RASAC-Dev/RASAC_board/KiCad_files/RASAC.kicad_pcb

## KiCad design KiCad_files/RASAC.kicad_pcb (2019-04-03)

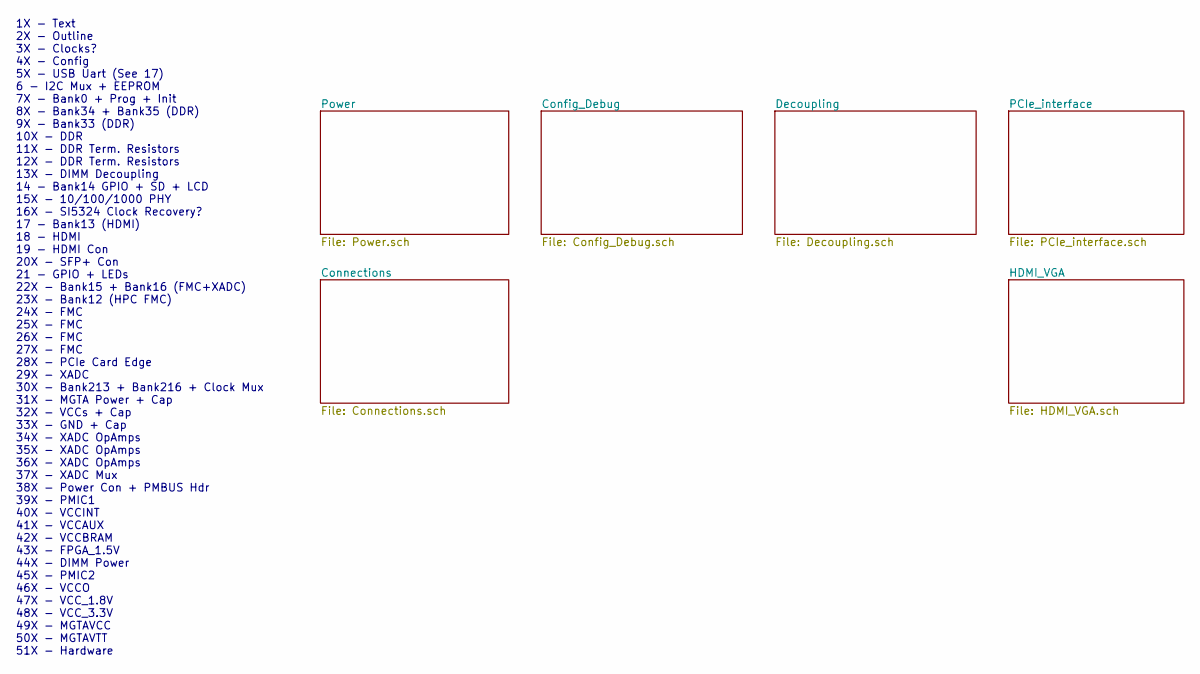
[picture p10: schematic RASAC.sch, Reconfigurable Application-Specific Accelerator Card]

Notes on the sheet:
1X - Text 2X - Outline 3X - Clocks? 4X - Config 5X - USB Uart (See 17) 6 - I2C Mux + EEPROM 7X - Bank0 + Prog + Init 8X - Bank34 + Bank35 (DDR) 9X - Bank33 (DDR) 10X - DDR 11X - DDR Term. Resistors 12X - DDR Term. Resistors 13X - DIMM Decoupling 14 - Bank14 GPIO + SD + LCD 15X - 10/100/1000 PHY 16X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

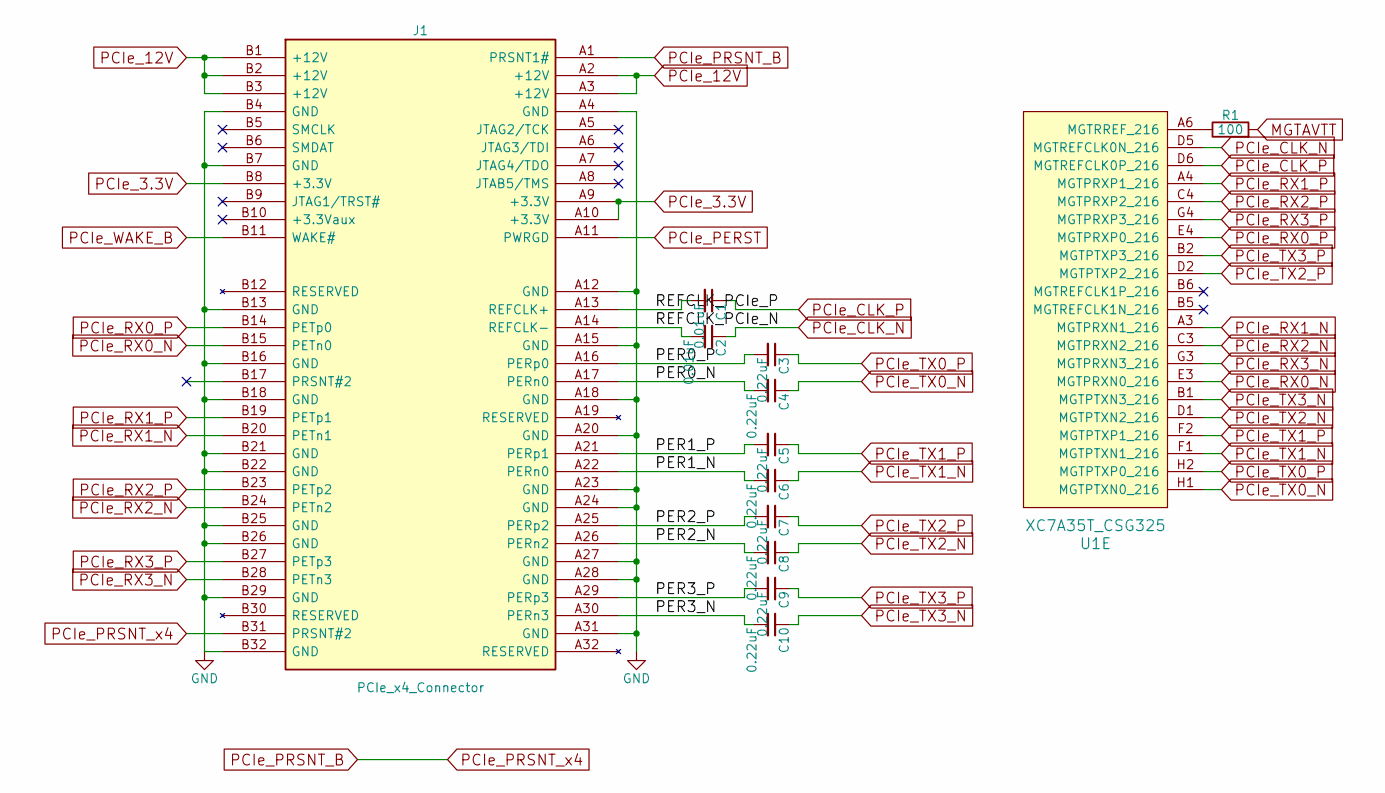
[picture p11: schematic PCIe_interface.sch, Reconfigurable Application-Specific Accelerator Card]

Parts:
C1, C2: 0.01uF; C_1206
C3, C4, C5, C6, C7, C8, C9, C10: 0.22uF; C_0805
J1: PCIe_x4_Connector; pciex4fingers
R1: 100; R_0603
U1: XC7A35T_CSG325; BGA-324_15.0x15.0mm_Layout18x18_P0.8mm_Ball0.5mm_Pad0.4mm_N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

Connections:
/PCIe_interface/PER0_N: C4.2, J1.A17 (PERn0)
/PCIe_interface/PER0_P: C3.2, J1.A16 (PERp0)
/PCIe_interface/PER1_N: C6.2, J1.A22 (PERn0)
/PCIe_interface/PER1_P: C5.2, J1.A21 (PERp1)
/PCIe_interface/PER2_N: C8.2, J1.A26 (PERn2)
/PCIe_interface/PER2_P: C7.2, J1.A25 (PERp2)
/PCIe_interface/PER3_N: C10.2, J1.A30 (PERn3)
/PCIe_interface/PER3_P: C9.2, J1.A29 (PERp3)
/PCIe_interface/REFCLK_PCIe_N: C2.2, J1.A14 (REFCLK-)
/PCIe_interface/REFCLK_PCIe_P: C1.2, J1.A13 (REFCLK+)
GND: J1.A4 (GND), J1.A12 (GND), J1.A15 (GND), J1.A18 (GND), J1.A20 (GND), J1.A23 (GND), J1.A24 (GND), J1.A27 (GND), J1.A28 (GND), J1.A31 (GND), J1.B4 (GND), J1.B7 (GND), J1.B13 (GND), J1.B16 (GND), J1.B18 (GND), J1.B21 (GND), J1.B22 (GND), J1.B25 (GND), J1.B26 (GND), J1.B29 (GND), J1.B32 (GND); also elsewhere on the board
MGTAVTT: R1.2; also elsewhere on the board
unnamed: R1.1, U1.A6 (MGTRREF_216)
PCIe_3.3V: J1.A9 (+3.3V), J1.A10 (+3.3V), J1.B8 (+3.3V); also elsewhere on the board
PCIe_12V: J1.A2 (+12V), J1.A3 (+12V), J1.B1 (+12V), J1.B2 (+12V), J1.B3 (+12V); also elsewhere on the board
PCIe_CLK_N: C2.1, U1.D5 (MGTREFCLK0N_216)
PCIe_CLK_P: C1.1, U1.D6 (MGTREFCLK0P_216)
PCIe_PERST: J1.A11 (PWRGD); also elsewhere on the board
PCIe_PRSNT_B: J1.A1 (PRSNT1#), J1.B31 (PRSNT#2)
PCIe_RX0_N: J1.B15 (PETn0), U1.E3 (MGTPRXN0_216)
PCIe_RX0_P: J1.B14 (PETp0), U1.E4 (MGTPRXP0_216)
PCIe_RX1_N: J1.B20 (PETn1), U1.A3 (MGTPRXN1_216)
PCIe_RX1_P: J1.B19 (PETp1), U1.A4 (MGTPRXP1_216)
PCIe_RX2_N: J1.B24 (PETn2), U1.C3 (MGTPRXN2_216)
PCIe_RX2_P: J1.B23 (PETp2), U1.C4 (MGTPRXP2_216)
PCIe_RX3_N: J1.B28 (PETn3), U1.G3 (MGTPRXN3_216)
PCIe_RX3_P: J1.B27 (PETp3), U1.G4 (MGTPRXP3_216)
PCIe_TX0_N: C4.1, U1.H1 (MGTPTXN0_216)
PCIe_TX0_P: C3.1, U1.H2 (MGTPTXP0_216)
PCIe_TX1_N: C6.1, U1.F1 (MGTPTXN1_216)
PCIe_TX1_P: C5.1, U1.F2 (MGTPTXP1_216)
PCIe_TX2_N: C8.1, U1.D1 (MGTPTXN2_216)
PCIe_TX2_P: C7.1, U1.D2 (MGTPTXP2_216)
PCIe_TX3_N: C10.1, U1.B1 (MGTPTXN3_216)
PCIe_TX3_P: C9.1, U1.B2 (MGTPTXP3_216)
PCIe_WAKE_B: J1.B11 (WAKE#); also elsewhere on the board

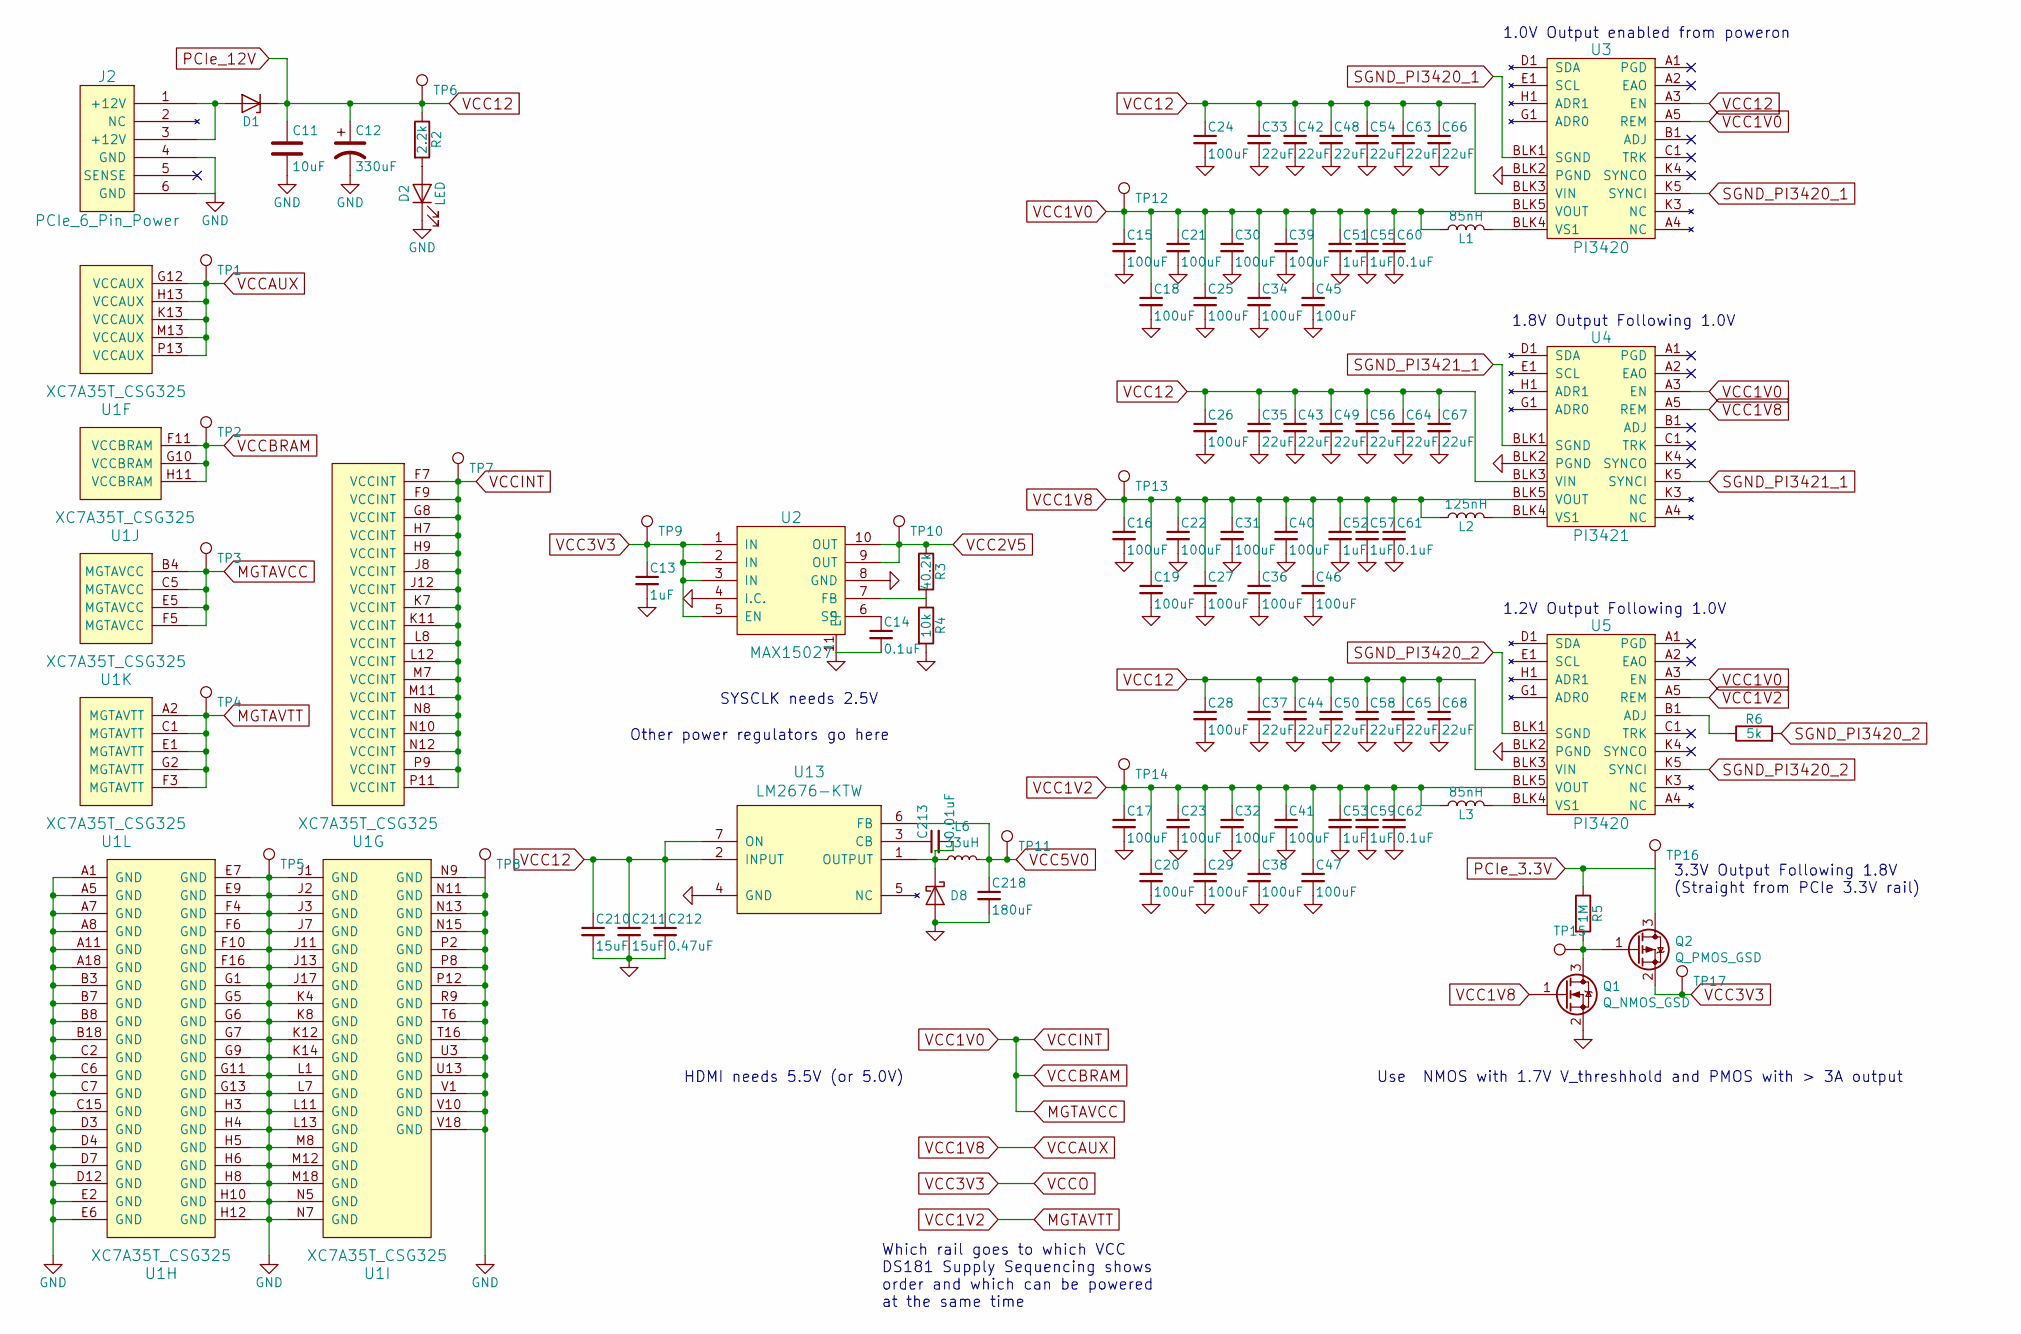
[picture p12: schematic Power.sch, Reconfigurable Application-Specific Accelerator Card]

Parts:
C11: 10uF; C_0805
C12: 330uF; C_1210
C13, C51, C52, C53, C55, C57, C59: 1uF; C_0805
C14: 0.1uF; C_0402
C15, C16, C17, C18, C19, C20, C21, C22, C23, C24, C25, C26, C27, C28, C29, C30, C31, C32, C34, C36, C38, C39, C40, C41, C45, C46, C47: 100uF; C_1210
C33, C35, C37, C42, C43, C44, C48, C49, C50, C54, C56, C58, C63, C64, C65, C66, C67, C68: 22uF; C_0805
C60, C61, C62: 0.1uF; C_0805
C210, C211: 15uF; C_1210
C212: 0.47uF; C_0805
C213: 0.01uF; C_1206
C218: 180uF; C_1206
D1: D_Zener; D_SOD-123
D2: LED; LED_0603
D8: D_Schottky; D_SOD-123
J2: PCIe_6_Pin_Power; Molex_MiniFit-JR-5569-06A2_2x03x4.20mm_Angled
L1, L3: 85nH; L_1210
L2: 125nH; L_1210
L6: 33uH; L_0805
Q1: Q_NMOS_GSD; SOT-23
Q2: Q_PMOS_GSD; SOT-23
R2: 2.2k; R_0805
R3: 40.2k; R_0402
R4: 10k; R_0805
R5: 1M; R_0603
R6: 5k; R_0805
TP1, TP2, TP3, TP4, TP5, TP6, TP7, TP8, TP9, TP10, TP11, TP12, TP13, TP14, TP15, TP16, TP17: TestPoint; Measurement_Point_Round-SMD-Pad_Small
U1: XC7A35T_CSG325; BGA-324_15.0x15.0mm_Layout18x18_P0.8mm_Ball0.5mm_Pad0.4mm_N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
U2: MAX15027; TDFN-10_3x3mm_Pitch0.5mm
U3, U5: PI3420; LGA-123_10x14mm_Pitch1.0mm
U4: PI3421; LGA-123_10x14mm_Pitch1.0mm
U13: LM2676-KTW; TO-263-7_TabPin4

Connections:
GND: C11.2, C12.2, C13.2, C14.2, C15.2, C16.2, C17.2, C18.2, C19.2, C20.2, C21.2, C22.2, C23.2, C24.2, C25.2, C26.2, C27.2, C28.2, C29.2, C30.2, C31.2, C32.2, C33.2, C34.2, C35.2, C36.2, C37.2, C38.2, C39.2, C40.2, C41.2, C42.2, C43.2, C44.2, C45.2, C46.2, C47.2, C48.2, C49.2, C50.2, C51.2, C52.2, C53.2, C54.2, C55.2, C56.2, C57.2, C58.2, C59.2, C60.2, C61.2, C62.2, C63.2, C64.2, C65.2, C66.2, C67.2, C68.2, C210.2, C211.2, C212.2, C218.2, D2.1 (K), D8.2 (A), J2.4 (GND), J2.6 (GND), Q1.2 (S), R4.2, TP5.1, TP8.1, U1.A1 (GND), U1.A5 (GND), U1.A7 (GND), U1.A8 (GND), U1.A11 (GND), U1.A18 (GND), U1.B3 (GND), U1.B7 (GND), U1.B8 (GND), U1.B18 (GND), U1.C2 (GND), U1.C6 (GND), U1.C7 (GND), U1.C15 (GND), U1.D3 (GND), U1.D4 (GND), U1.D7 (GND), U1.D12 (GND), U1.E2 (GND), U1.E6 (GND), U1.E7 (GND), U1.E9 (GND), U1.F4 (GND), U1.F6 (GND), U1.F10 (GND), U1.F16 (GND), U1.G1 (GND), U1.G5 (GND), U1.G6 (GND), U1.G7 (GND), U1.G9 (GND), U1.G11 (GND), U1.G13 (GND), U1.H3 (GND), U1.H4 (GND), U1.H5 (GND), U1.H6 (GND), U1.H8 (GND), U1.H10 (GND), U1.H12 (GND), U1.J1 (GND), U1.J2 (GND), U1.J3 (GND), U1.J7 (GND), U1.J11 (GND), U1.J13 (GND), U1.J17 (GND), U1.K4 (GND), U1.K8 (GND), U1.K12 (GND), U1.K14 (GND), U1.L1 (GND), U1.L7 (GND), U1.L11 (GND), U1.L13 (GND), U1.M8 (GND), U1.M12 (GND), U1.M18 (GND), U1.N5 (GND), U1.N7 (GND), U1.N9 (GND), U1.N11 (GND), U1.N13 (GND), U1.N15 (GND), U1.P2 (GND), U1.P8 (GND), U1.P12 (GND), U1.R9 (GND), U1.T6 (GND), U1.T16 (GND), U1.U3 (GND), U1.U13 (GND), U1.V1 (GND), U1.V10 (GND), U1.V18 (GND), U2.4 (I.C.), U2.8 (GND), U2.11 (EP), U3.BLK2 (PGND), U4.BLK2 (PGND), U5.BLK2 (PGND), U13.4 (GND); also elsewhere on the board
MGTAVCC: C15.1, C18.1, C21.1, C25.1, C30.1, C34.1, C39.1, C45.1, C51.1, C55.1, C60.1, L1.1, TP2.1, TP3.1, TP7.1, TP12.1, U1.B4 (MGTAVCC), U1.C5 (MGTAVCC), U1.E5 (MGTAVCC), U1.F5 (MGTAVCC), U1.F7 (VCCINT), U1.F9 (VCCINT), U1.F11 (VCCBRAM), U1.G8 (VCCINT), U1.G10 (VCCBRAM), U1.H7 (VCCINT), U1.H9 (VCCINT), U1.H11 (VCCBRAM), U1.J8 (VCCINT), U1.J12 (VCCINT), U1.K7 (VCCINT), U1.K11 (VCCINT), U1.L8 (VCCINT), U1.L12 (VCCINT), U1.M7 (VCCINT), U1.M11 (VCCINT), U1.N8 (VCCINT), U1.N10 (VCCINT), U1.N12 (VCCINT), U1.P9 (VCCINT), U1.P11 (VCCINT), U3.A5 (REM), U3.BLK5 (VOUT), U4.A3 (EN), U5.A3 (EN); also elsewhere on the board
MGTAVTT: C17.1, C20.1, C23.1, C29.1, C32.1, C38.1, C41.1, C47.1, C53.1, C59.1, C62.1, L3.1, TP4.1, TP14.1, U1.A2 (MGTAVTT), U1.C1 (MGTAVTT), U1.E1 (MGTAVTT), U1.F3 (MGTAVTT), U1.G2 (MGTAVTT), U5.A5 (REM), U5.BLK5 (VOUT); also elsewhere on the board
unnamed: C14.1, U2.6 (SS)
unnamed: C213.1, U13.3 (CB)
unnamed: C213.2, D8.1 (K), L6.1, U13.1 (OUTPUT)
unnamed: D1.2 (A), J2.1 (+12V), J2.3 (+12V)
unnamed: D2.2 (A), R2.2
unnamed: L1.2, U3.BLK4 (VS1)
unnamed: L2.2, U4.BLK4 (VS1)
unnamed: L3.2, U5.BLK4 (VS1)
unnamed: Q1.3 (D), Q2.1 (G), R5.2, TP15.1
unnamed: R3.2, R4.1, U2.7 (FB)
unnamed: R6.1, U5.B1 (ADJ)
PCIe_3.3V: Q2.3 (D), R5.1, TP16.1; also elsewhere on the board
PCIe_12V: C11.1, C12.1, C24.1, C26.1, C28.1, C33.1, C35.1, C37.1, C42.1, C43.1, C44.1, C48.1, C49.1, C50.1, C54.1, C56.1, C58.1, C63.1, C64.1, C65.1, C66.1, C67.1, C68.1, C210.1, C211.1, C212.1, D1.1 (K), R2.1, TP6.1, U3.A3 (EN), U3.BLK3 (VIN), U4.BLK3 (VIN), U5.BLK3 (VIN), U13.2 (INPUT), U13.7 (ON); also elsewhere on the board
SGND_PI3420_1: U3.BLK1 (SGND), U3.K5 (SYNCI)
SGND_PI3420_2: R6.2, U5.BLK1 (SGND), U5.K5 (SYNCI)
SGND_PI3421_1: U4.BLK1 (SGND), U4.K5 (SYNCI)
VCC1V8: C16.1, C19.1, C22.1, C27.1, C31.1, C36.1, C40.1, C46.1, C52.1, C57.1, C61.1, L2.1, Q1.1 (G), TP1.1, TP13.1, U1.G12 (VCCAUX), U1.H13 (VCCAUX), U1.K13 (VCCAUX), U1.M13 (VCCAUX), U1.P13 (VCCAUX), U4.A5 (REM), U4.BLK5 (VOUT); also elsewhere on the board
VCC2V5: R3.1, TP10.1, U2.9 (OUT), U2.10 (OUT); also elsewhere on the board
VCC3V3: C13.1, Q2.2 (S), TP9.1, TP17.1, U2.1 (IN), U2.2 (IN), U2.3 (IN), U2.5 (EN); also elsewhere on the board
VCC5V0: C218.1, L6.2, TP11.1, U13.6 (FB); also elsewhere on the board

Notes on the sheet:
Use NMOS with 1.7V V_threshhold and PMOS with > 3A output
Other power regulators go here
1.2V Output Following 1.0V
1.8V Output Following 1.0V
1.0V Output enabled from poweron
3.3V Output Following 1.8V (Straight from PCIe 3.3V rail)
Which rail goes to which VCC DS181 Supply Sequencing shows order and which can be powered at the same time
SYSCLK needs 2.5V
HDMI needs 5.5V (or 5.0V)

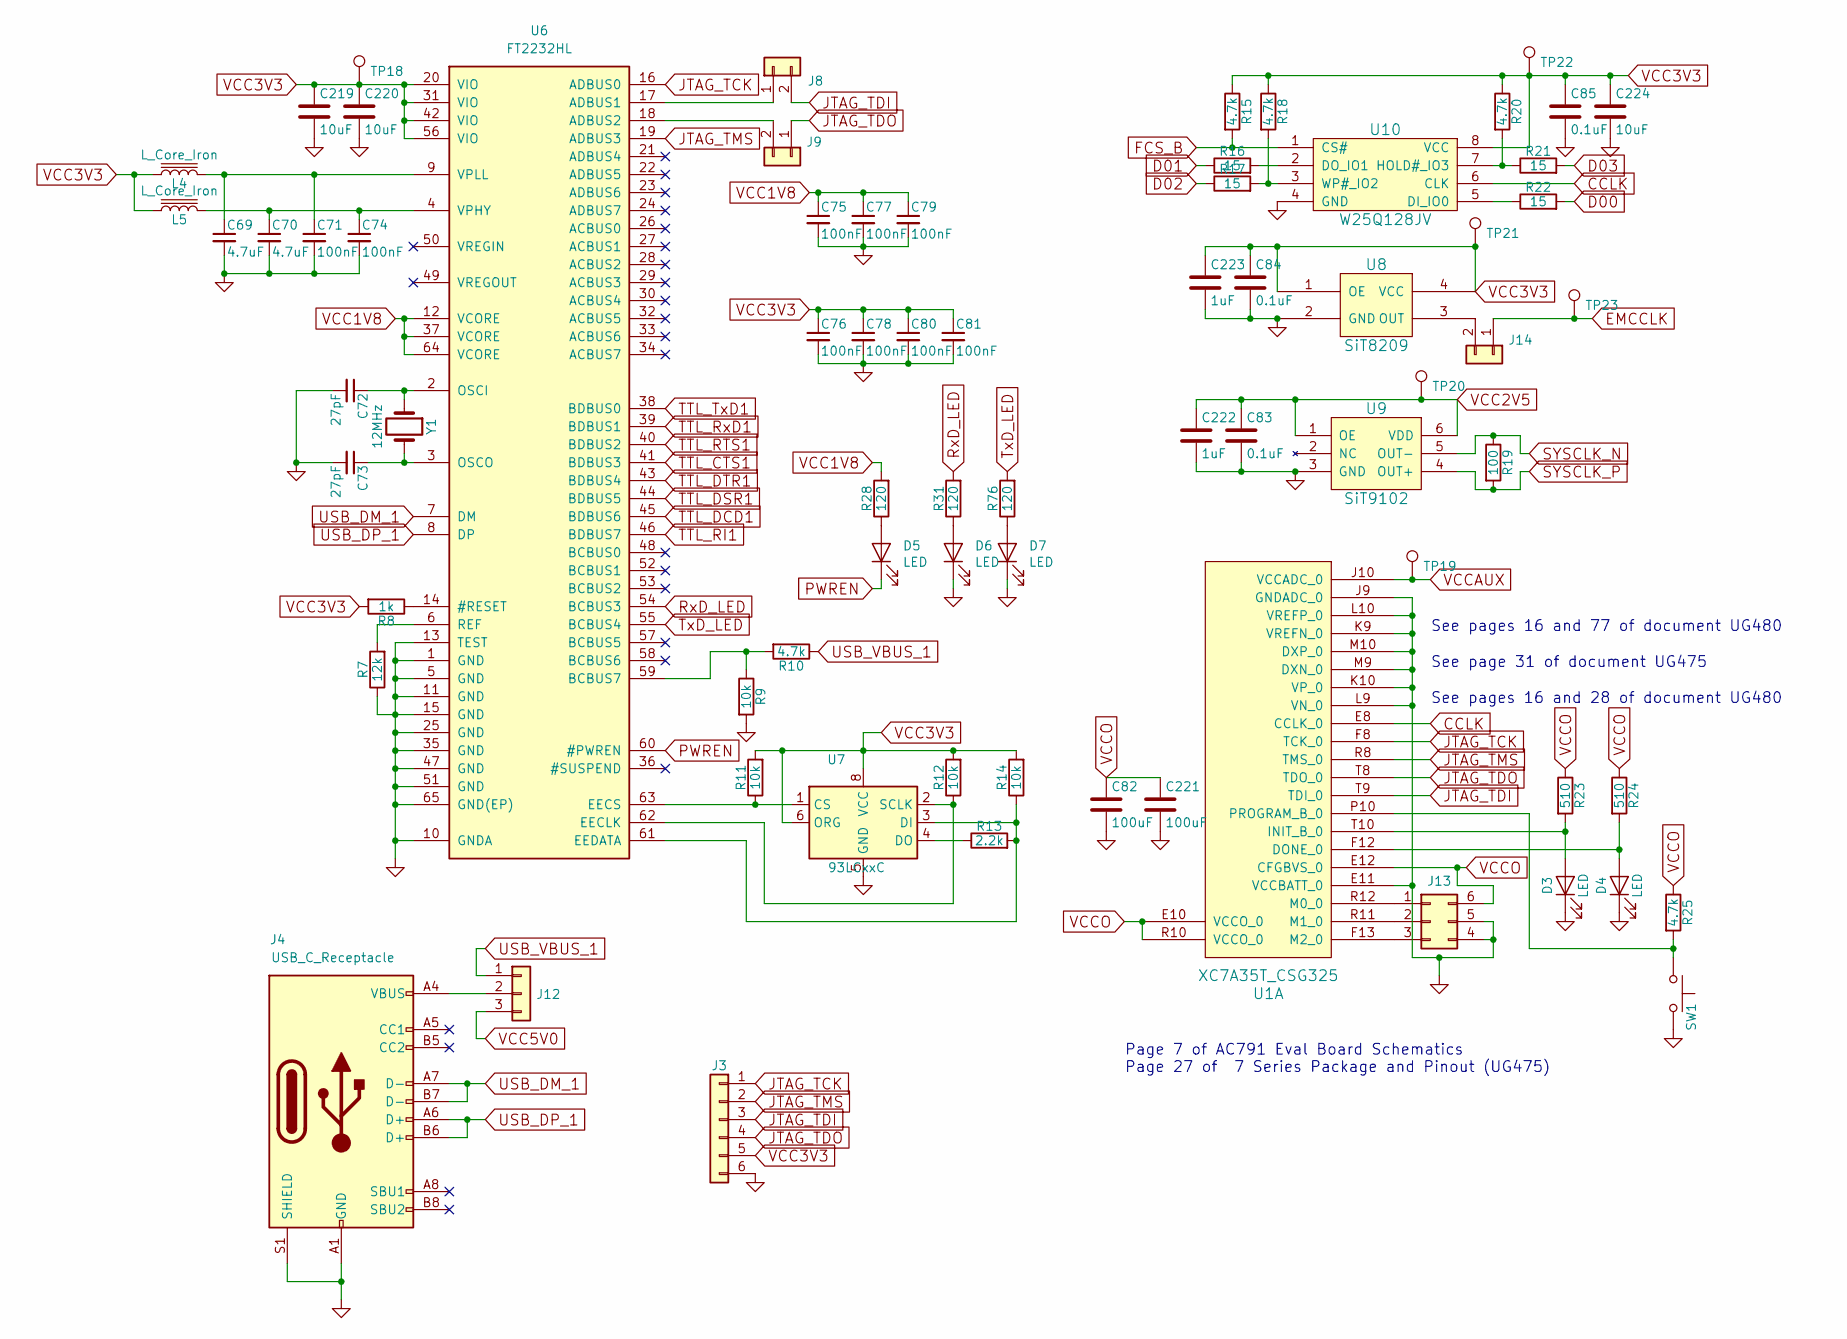
[picture p13: schematic Config_Debug.sch, Reconfigurable Application-Specific Accelerator Card]

Parts:
C69, C70: 4.7uF; C_0603
C71, C74, C75, C76, C77, C78, C79, C80, C81: 100nF; C_0805
C72, C73: 27pF; C_0805
C82: 100uF; C_0805
C83, C84, C85: 0.1uF; C_0805
C219, C220, C224: 10uF; C_0805
C221: 100uF; C_1210
C222, C223: 1uF; C_0805
D3, D4, D5, D6, D7: LED; LED_0603
J3: Conn_01x06; Pin_Header_Straight_2x03_Pitch2.54mm
J4: USB_C_Receptacle; USB_C_Receptacle_Amphenol_12401610E4-2A
J8, J9, J14: Conn_01x02; Pin_Header_Straight_1x02_Pitch2.54mm
J12: Conn_01x03; Pin_Header_Straight_1x03_Pitch2.54mm
J13: Conn_02x03_Counter_Clockwise; Pin_Header_Straight_2x03_Pitch2.54mm_SMD
L4, L5: L_Core_Iron; L_0805
R7: 12k; R_0402
R8: 1k; R_0805
R9, R11, R12, R14: 10k; R_0805
R10, R15, R18, R20, R25: 4.7k; R_0805
R13: 2.2k; R_0805
R16, R17, R21, R22: 15; R_0805
R19: 100; R_0603
R23, R24: 510; R_0805
R28, R31, R76: 120; R_0805
SW1: SW_Push; SW_SPST_PTS645
TP18, TP19, TP20, TP21, TP22, TP23: TestPoint; Measurement_Point_Round-SMD-Pad_Small
U1: XC7A35T_CSG325; BGA-324_15.0x15.0mm_Layout18x18_P0.8mm_Ball0.5mm_Pad0.4mm_N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
U6: FT2232HL; LQFP-64-1EP_10x10mm_Pitch0.5mm; MPN FT2232HL
U7: 93LCxxC; SOIC-8-N
U8: SiT8209; 4-SMD
U9: SiT9102; 6-SMD
U10: W25Q128JV; SOIC-8-N
Y1: 12MHz; Crystal_SMD_HC49-SD

Connections:
CCLK: U1.E8 (CCLK_0), U10.6 (CLK)
D00: R22.2; also elsewhere on the board
D01: R16.1; also elsewhere on the board
D02: R17.1; also elsewhere on the board
D03: R21.2; also elsewhere on the board
EMCCLK: J14.1, TP23.1; also elsewhere on the board
FCS_B: R15.2, U10.1 (CS#); also elsewhere on the board
GND: C69.2, C70.2, C71.2, C72.2, C73.2, C74.2, C75.2, C76.2, C77.2, C78.2, C79.2, C80.2, C81.2, C82.2, C83.2, C84.2, C85.2, C219.2, C220.2, C221.2, C222.2, C223.2, C224.2, D3.1 (K), D4.1 (K), D6.1 (K), D7.1 (K), J3.6, J4.A1 (GND), J4.A12 (GND), J4.B1 (GND), J4.B12 (GND), J4.S1 (SHIELD), J13.4, J13.5, R7.1, R9.2, SW1.2, U1.E11 (VCCBATT_0), U1.J9 (GNDADC_0), U1.K9 (VREFN_0), U1.K10 (VP_0), U1.L9 (VN_0), U1.L10 (VREFP_0), U1.M9 (DXN_0), U1.M10 (DXP_0), U6.1 (GND), U6.5 (GND), U6.10 (GNDA), U6.11 (GND), U6.13 (TEST), U6.15 (GND), U6.25 (GND), U6.35 (GND), U6.47 (GND), U6.51 (GND), U6.65 (GND(EP)), U7.5 (GND), U8.2 (GND), U9.3 (GND), U10.4 (GND); also elsewhere on the board
JTAG_TCK: J3.1, U1.F8 (TCK_0), U6.16 (ADBUS0)
JTAG_TDI: J3.3, J8.2, U1.T9 (TDI_0)
JTAG_TDO: J3.4, J9.1, U1.T8 (TDO_0)
JTAG_TMS: J3.2, U1.R8 (TMS_0), U6.19 (ADBUS3)
unnamed: C69.1, C71.1, L4.2, U6.9 (VPLL)
unnamed: C70.1, C74.1, L5.2, U6.4 (VPHY)
unnamed: C72.1, U6.2 (OSCI), Y1.1
unnamed: C73.1, U6.3 (OSCO), Y1.2
unnamed: D3.2 (A), R23.2, U1.T10 (INIT_B_0)
unnamed: D4.2 (A), R24.2, U1.F12 (DONE_0)
unnamed: D5.2 (A), R28.1
unnamed: D6.2 (A), R31.1
unnamed: D7.2 (A), R76.1
unnamed: J8.1, U6.17 (ADBUS1)
unnamed: J9.2, U6.18 (ADBUS2)
unnamed: J4.A4 (VBUS), J4.A9 (VBUS), J4.B4 (VBUS), J4.B9 (VBUS), J12.2
unnamed: J13.1, U1.R12 (M0_0)
unnamed: J13.2, U1.R11 (M1_0)
unnamed: J13.3, U1.F13 (M2_0)
unnamed: J14.2, U8.3 (OUT)
unnamed: R7.2, U6.6 (REF)
unnamed: R8.1, U6.14 (#RESET)
unnamed: R9.1, R10.2, U6.59 (BCBUS7)
unnamed: R11.1, U6.63 (EECS), U7.1 (CS)
unnamed: R12.1, U6.62 (EECLK), U7.2 (SCLK)
unnamed: R13.1, U7.4 (DO)
unnamed: R13.2, R14.1, U6.61 (EEDATA), U7.3 (DI)
unnamed: R16.2, U10.2 (DO_IO1)
unnamed: R17.2, R18.2, U10.3 (WP#_IO2)
unnamed: R20.2, R21.1, U10.7 (HOLD#_IO3)
unnamed: R22.1, U10.5 (DI_IO0)
unnamed: R25.2, SW1.1, U1.P10 (PROGRAM_B_0)
PWREN: D5.1 (K), U6.60 (#PWREN)
RxD_LED: R31.2, U6.54 (BCBUS3)
SYSCLK_N: R19.1, U9.5 (OUT-); also elsewhere on the board
SYSCLK_P: R19.2, U9.4 (OUT+); also elsewhere on the board
TTL_CTS1: U6.41 (BDBUS3); also elsewhere on the board
TTL_DCD1: U6.45 (BDBUS6); also elsewhere on the board
TTL_DSR1: U6.44 (BDBUS5); also elsewhere on the board
TTL_DTR1: U6.43 (BDBUS4); also elsewhere on the board
TTL_RI1: U6.46 (BDBUS7); also elsewhere on the board
TTL_RTS1: U6.40 (BDBUS2); also elsewhere on the board
TTL_RxD1: U6.39 (BDBUS1); also elsewhere on the board
TTL_TxD1: U6.38 (BDBUS0); also elsewhere on the board
TxD_LED: R76.2, U6.55 (BCBUS4)
USB_DM_1: J4.A7 (D-), J4.B7 (D-), U6.7 (DM)
USB_DP_1: J4.A6 (D+), J4.B6 (D+), U6.8 (DP)
USB_VBUS_1: J12.1, R10.1
VCC1V8: C75.1, C77.1, C79.1, R28.2, TP19.1, U1.J10 (VCCADC_0), U6.12 (VCORE), U6.37 (VCORE), U6.64 (VCORE); also elsewhere on the board
VCC2V5: C83.1, C222.1, TP20.1, U9.1 (OE), U9.6 (VDD); also elsewhere on the board
VCC3V3: C76.1, C78.1, C80.1, C81.1, C82.1, C84.1, C85.1, C219.1, C220.1, C221.1, C223.1, C224.1, J3.5, J13.6, L4.1, L5.1, R8.2, R11.2, R12.2, R14.2, R15.1, R18.1, R20.1, R23.1, R24.1, R25.1, TP18.1, TP21.1, TP22.1, U1.E10 (VCCO_0), U1.E12 (CFGBVS_0), U1.R10 (VCCO_0), U6.20 (VIO), U6.31 (VIO), U6.42 (VIO), U6.56 (VIO), U7.6 (ORG), U7.8 (VCC), U8.1 (OE), U8.4 (VCC), U10.8 (VCC); also elsewhere on the board
VCC5V0: J12.3; also elsewhere on the board

Notes on the sheet:
Page 7 of AC791 Eval Board Schematics Page 27 of 7 Series Package and Pinout (UG475)
See pages 16 and 77 of document UG480
See pages 16 and 28 of document UG480
See page 31 of document UG475

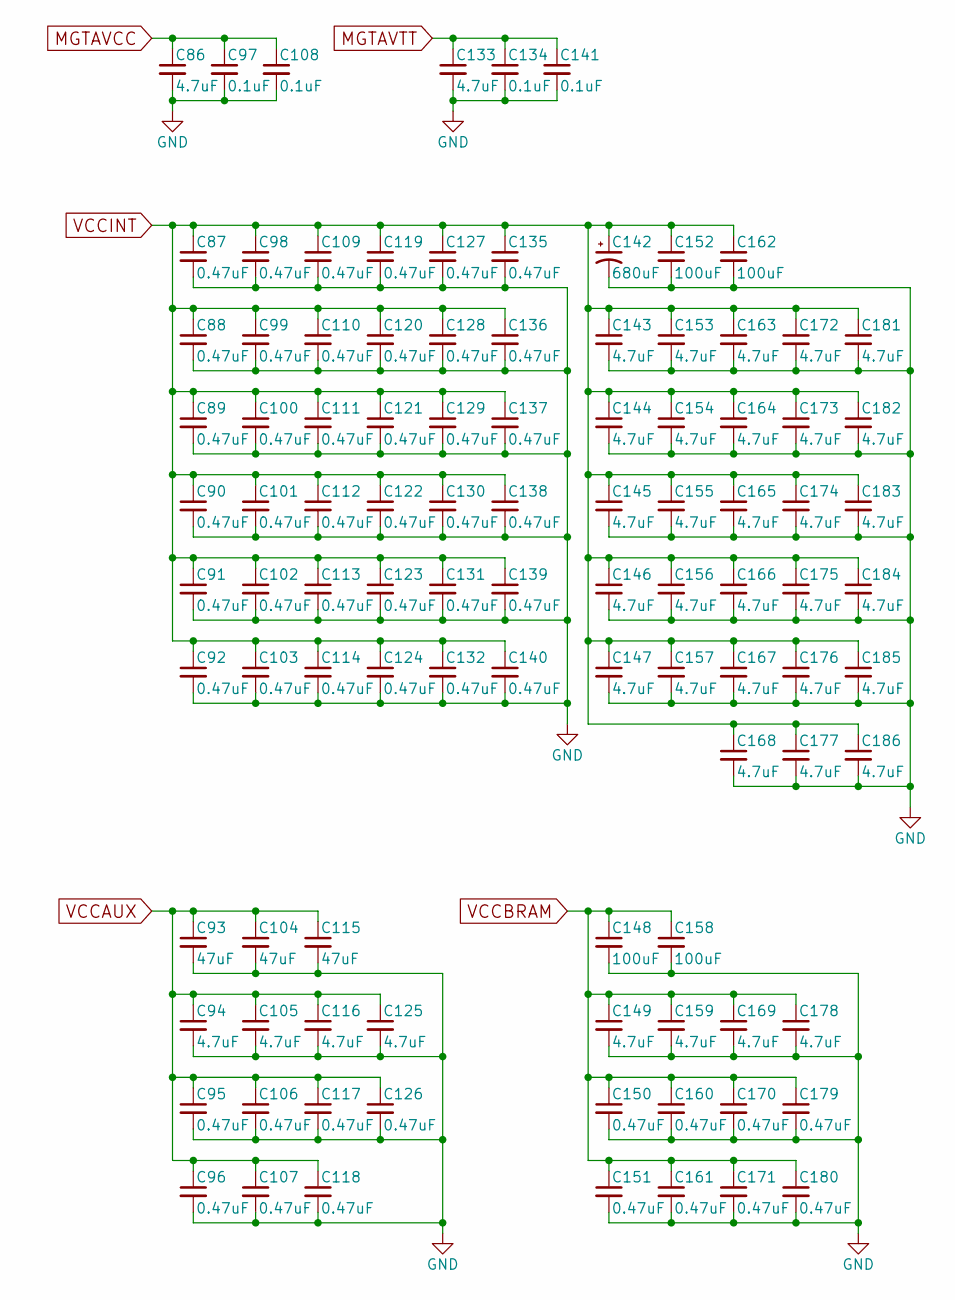
[picture p14: schematic Decoupling.sch, Reconfigurable Application-Specific Accelerator Card]

Parts:
C86, C94, C105, C116, C125, C133, C143, C144, C145, C146, C147, C149, C153, C154, C155, C156, C157, C159, C163, C164, C165, C166, C167, C168, C169, C172, C173, C174, C175, C176, C177, C178, C181, C182, C183, C184, C185, C186: 4.7uF; C_0603
C87, C88, C89, C90, C91, C92, C95, C96, C98, C99, C100, C101, C102, C103, C106, C107, C109, C110, C111, C112, C113, C114, C117, C118, C119, C120, C121, C122, C123, C124, C126, C127, C128, C129, C130, C131, C132, C135, C136, C137, C138, C139, C140, C150, C151, C160, C161, C170, C171, C179, C180: 0.47uF; C_0805
C93, C104, C115: 47uF; C_0805
C97, C108, C134, C141: 0.1uF; C_0805
C142: 680uF; CP_Tantalum_Case-D_EIA-7343-31_Wave
C148, C152, C158, C162: 100uF; C_1210

Connections:
GND: C86.2, C87.2, C88.2, C89.2, C90.2, C91.2, C92.2, C93.2, C94.2, C95.2, C96.2, C97.2, C98.2, C99.2, C100.2, C101.2, C102.2, C103.2, C104.2, C105.2, C106.2, C107.2, C108.2, C109.2, C110.2, C111.2, C112.2, C113.2, C114.2, C115.2, C116.2, C117.2, C118.2, C119.2, C120.2, C121.2, C122.2, C123.2, C124.2, C125.2, C126.2, C127.2, C128.2, C129.2, C130.2, C131.2, C132.2, C133.2, C134.2, C135.2, C136.2, C137.2, C138.2, C139.2, C140.2, C141.2, C142.2, C143.2, C144.2, C145.2, C146.2, C147.2, C148.2, C149.2, C150.2, C151.2, C152.2, C153.2, C154.2, C155.2, C156.2, C157.2, C158.2, C159.2, C160.2, C161.2, C162.2, C163.2, C164.2, C165.2, C166.2, C167.2, C168.2, C169.2, C170.2, C171.2, C172.2, C173.2, C174.2, C175.2, C176.2, C177.2, C178.2, C179.2, C180.2, C181.2, C182.2, C183.2, C184.2, C185.2, C186.2; also elsewhere on the board
MGTAVCC: C86.1, C87.1, C88.1, C89.1, C90.1, C91.1, C92.1, C97.1, C98.1, C99.1, C100.1, C101.1, C102.1, C103.1, C108.1, C109.1, C110.1, C111.1, C112.1, C113.1, C114.1, C119.1, C120.1, C121.1, C122.1, C123.1, C124.1, C127.1, C128.1, C129.1, C130.1, C131.1, C132.1, C135.1, C136.1, C137.1, C138.1, C139.1, C140.1, C142.1, C143.1, C144.1, C145.1, C146.1, C147.1, C148.1, C149.1, C150.1, C151.1, C152.1, C153.1, C154.1, C155.1, C156.1, C157.1, C158.1, C159.1, C160.1, C161.1, C162.1, C163.1, C164.1, C165.1, C166.1, C167.1, C168.1, C169.1, C170.1, C171.1, C172.1, C173.1, C174.1, C175.1, C176.1, C177.1, C178.1, C179.1, C180.1, C181.1, C182.1, C183.1, C184.1, C185.1, C186.1; also elsewhere on the board
MGTAVTT: C133.1, C134.1, C141.1; also elsewhere on the board
VCC1V8: C93.1, C94.1, C95.1, C96.1, C104.1, C105.1, C106.1, C107.1, C115.1, C116.1, C117.1, C118.1, C125.1, C126.1; also elsewhere on the board

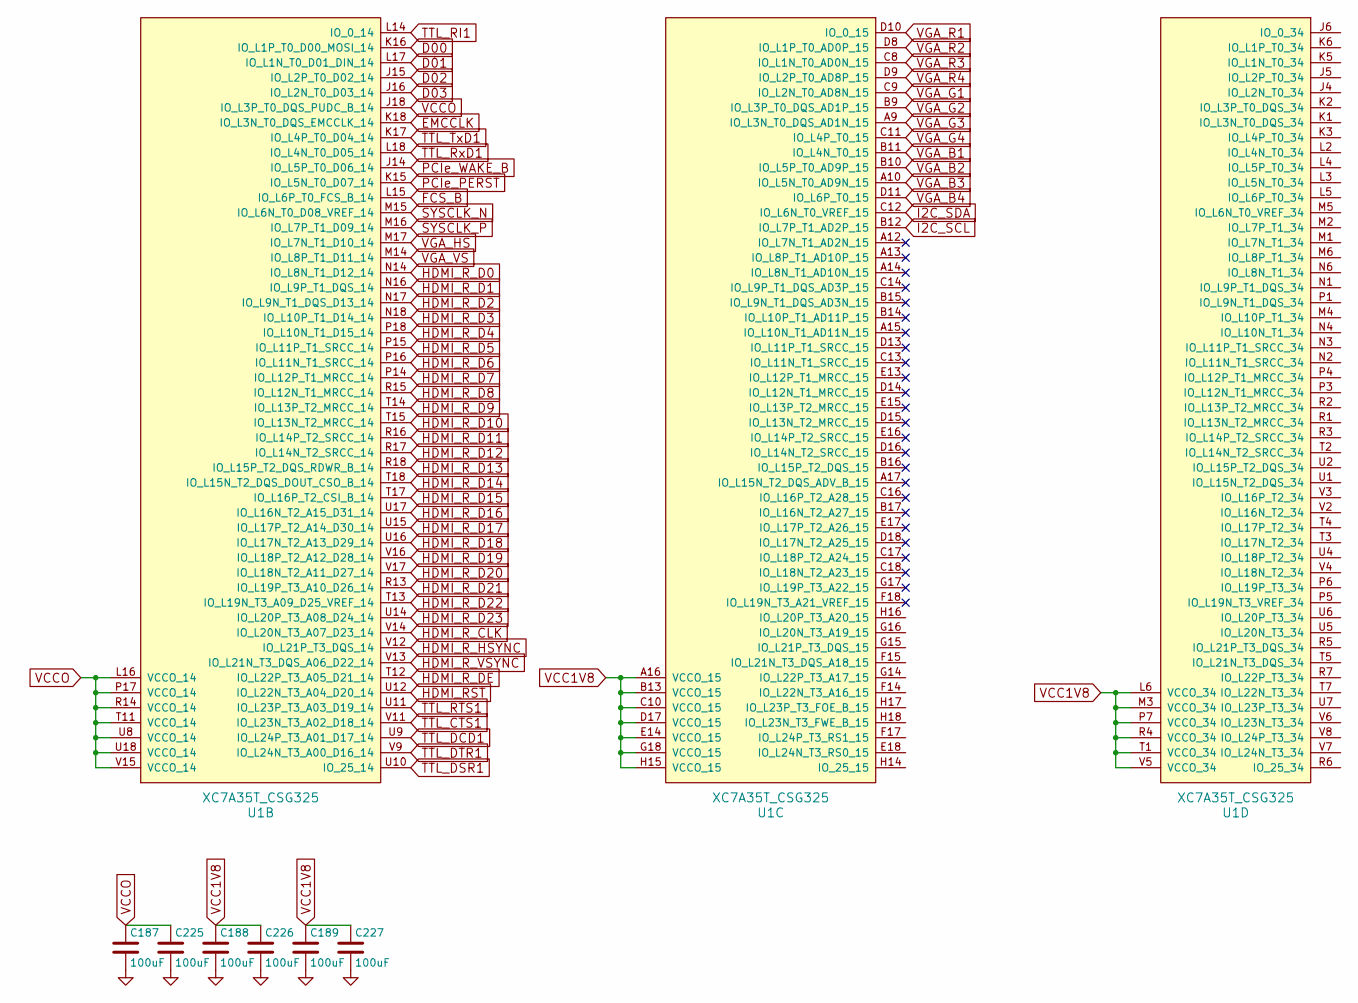
[picture p15: schematic Connections.sch, Reconfigurable Application-Specific Accelerator Card]

Parts:
C187, C188, C189, C225, C226, C227: 100uF; C_1210
U1: XC7A35T_CSG325; BGA-324_15.0x15.0mm_Layout18x18_P0.8mm_Ball0.5mm_Pad0.4mm_N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

Connections:
D00: U1.K16 (IO_L1P_T0_D00_MOSI_14); also elsewhere on the board
D01: U1.L17 (IO_L1N_T0_D01_DIN_14); also elsewhere on the board
D02: U1.J15 (IO_L2P_T0_D02_14); also elsewhere on the board
D03: U1.J16 (IO_L2N_T0_D03_14); also elsewhere on the board
EMCCLK: U1.K18 (IO_L3N_T0_DQS_EMCCLK_14); also elsewhere on the board
FCS_B: U1.L15 (IO_L6P_T0_FCS_B_14); also elsewhere on the board
GND: C187.2, C188.2, C189.2, C225.2, C226.2, C227.2; also elsewhere on the board
HDMI_RST: U1.U12 (IO_L22N_T3_A04_D20_14); also elsewhere on the board
HDMI_R_CLK: U1.V14 (IO_L20N_T3_A07_D23_14); also elsewhere on the board
HDMI_R_D0: U1.N14 (IO_L8N_T1_D12_14); also elsewhere on the board
HDMI_R_D1: U1.N16 (IO_L9P_T1_DQS_14); also elsewhere on the board
HDMI_R_D2: U1.N17 (IO_L9N_T1_DQS_D13_14); also elsewhere on the board
HDMI_R_D3: U1.N18 (IO_L10P_T1_D14_14); also elsewhere on the board
HDMI_R_D4: U1.P18 (IO_L10N_T1_D15_14); also elsewhere on the board
HDMI_R_D5: U1.P15 (IO_L11P_T1_SRCC_14); also elsewhere on the board
HDMI_R_D6: U1.P16 (IO_L11N_T1_SRCC_14); also elsewhere on the board
HDMI_R_D7: U1.P14 (IO_L12P_T1_MRCC_14); also elsewhere on the board
HDMI_R_D8: U1.R15 (IO_L12N_T1_MRCC_14); also elsewhere on the board
HDMI_R_D9: U1.T14 (IO_L13P_T2_MRCC_14); also elsewhere on the board
HDMI_R_D10: U1.T15 (IO_L13N_T2_MRCC_14); also elsewhere on the board
HDMI_R_D11: U1.R16 (IO_L14P_T2_SRCC_14); also elsewhere on the board
HDMI_R_D12: U1.R17 (IO_L14N_T2_SRCC_14); also elsewhere on the board
HDMI_R_D13: U1.R18 (IO_L15P_T2_DQS_RDWR_B_14); also elsewhere on the board
HDMI_R_D14: U1.T18 (IO_L15N_T2_DQS_DOUT_CSO_B_14); also elsewhere on the board
HDMI_R_D15: U1.T17 (IO_L16P_T2_CSI_B_14); also elsewhere on the board
HDMI_R_D16: U1.U17 (IO_L16N_T2_A15_D31_14); also elsewhere on the board
HDMI_R_D17: U1.U15 (IO_L17P_T2_A14_D30_14); also elsewhere on the board
HDMI_R_D18: U1.U16 (IO_L17N_T2_A13_D29_14); also elsewhere on the board
HDMI_R_D19: U1.V16 (IO_L18P_T2_A12_D28_14); also elsewhere on the board
HDMI_R_D20: U1.V17 (IO_L18N_T2_A11_D27_14); also elsewhere on the board
HDMI_R_D21: U1.R13 (IO_L19P_T3_A10_D26_14); also elsewhere on the board
HDMI_R_D22: U1.T13 (IO_L19N_T3_A09_D25_VREF_14); also elsewhere on the board
HDMI_R_D23: U1.U14 (IO_L20P_T3_A08_D24_14); also elsewhere on the board
HDMI_R_DE: U1.T12 (IO_L22P_T3_A05_D21_14); also elsewhere on the board
HDMI_R_HSYNC: U1.V12 (IO_L21P_T3_DQS_14); also elsewhere on the board
HDMI_R_VSYNC: U1.V13 (IO_L21N_T3_DQS_A06_D22_14); also elsewhere on the board
HDMI_SCL: U1.B12 (IO_L7P_T1_AD2P_15); also elsewhere on the board
HDMI_SDA: U1.C12 (IO_L6N_T0_VREF_15); also elsewhere on the board
PCIe_PERST: U1.K15 (IO_L5N_T0_D07_14); also elsewhere on the board
PCIe_WAKE_B: U1.J14 (IO_L5P_T0_D06_14); also elsewhere on the board
SYSCLK_N: U1.M15 (IO_L6N_T0_D08_VREF_14); also elsewhere on the board
SYSCLK_P: U1.M16 (IO_L7P_T1_D09_14); also elsewhere on the board
TTL_CTS1: U1.V11 (IO_L23N_T3_A02_D18_14); also elsewhere on the board
TTL_DCD1: U1.U9 (IO_L24P_T3_A01_D17_14); also elsewhere on the board
TTL_DSR1: U1.U10 (IO_25_14); also elsewhere on the board
TTL_DTR1: U1.V9 (IO_L24N_T3_A00_D16_14); also elsewhere on the board
TTL_RI1: U1.L14 (IO_0_14); also elsewhere on the board
TTL_RTS1: U1.U11 (IO_L23P_T3_A03_D19_14); also elsewhere on the board
TTL_RxD1: U1.L18 (IO_L4N_T0_D05_14); also elsewhere on the board
TTL_TxD1: U1.K17 (IO_L4P_T0_D04_14); also elsewhere on the board
VCC1V8: C188.1, C189.1, C226.1, C227.1, U1.A16 (VCCO_15), U1.B13 (VCCO_15), U1.C10 (VCCO_15), U1.D17 (VCCO_15), U1.E14 (VCCO_15), U1.G18 (VCCO_15), U1.H15 (VCCO_15), U1.L6 (VCCO_34), U1.M3 (VCCO_34), U1.P7 (VCCO_34), U1.R4 (VCCO_34), U1.T1 (VCCO_34), U1.V5 (VCCO_34); also elsewhere on the board
VCC3V3: C187.1, C225.1, U1.J18 (IO_L3P_T0_DQS_PUDC_B_14), U1.L16 (VCCO_14), U1.P17 (VCCO_14), U1.R14 (VCCO_14), U1.T11 (VCCO_14), U1.U8 (VCCO_14), U1.U18 (VCCO_14), U1.V15 (VCCO_14); also elsewhere on the board
VGA_B1: U1.B11 (IO_L4N_T0_15); also elsewhere on the board
VGA_B2: U1.B10 (IO_L5P_T0_AD9P_15); also elsewhere on the board
VGA_B3: U1.A10 (IO_L5N_T0_AD9N_15); also elsewhere on the board
VGA_B4: U1.D11 (IO_L6P_T0_15); also elsewhere on the board
VGA_G1: U1.C9 (IO_L2N_T0_AD8N_15); also elsewhere on the board
VGA_G2: U1.B9 (IO_L3P_T0_DQS_AD1P_15); also elsewhere on the board
VGA_G3: U1.A9 (IO_L3N_T0_DQS_AD1N_15); also elsewhere on the board
VGA_G4: U1.C11 (IO_L4P_T0_15); also elsewhere on the board
VGA_HS: U1.M17 (IO_L7N_T1_D10_14); also elsewhere on the board
VGA_R1: U1.D10 (IO_0_15); also elsewhere on the board
VGA_R2: U1.D8 (IO_L1P_T0_AD0P_15); also elsewhere on the board
VGA_R3: U1.C8 (IO_L1N_T0_AD0N_15); also elsewhere on the board
VGA_R4: U1.D9 (IO_L2P_T0_AD8P_15); also elsewhere on the board
VGA_VS: U1.M14 (IO_L8P_T1_D11_14); also elsewhere on the board
