RASAC-Dev/RASAC_board/KiCad_files/RASAC.kicad_pcb

## KiCad design KiCad_files/RASAC.kicad_pcb (continued)

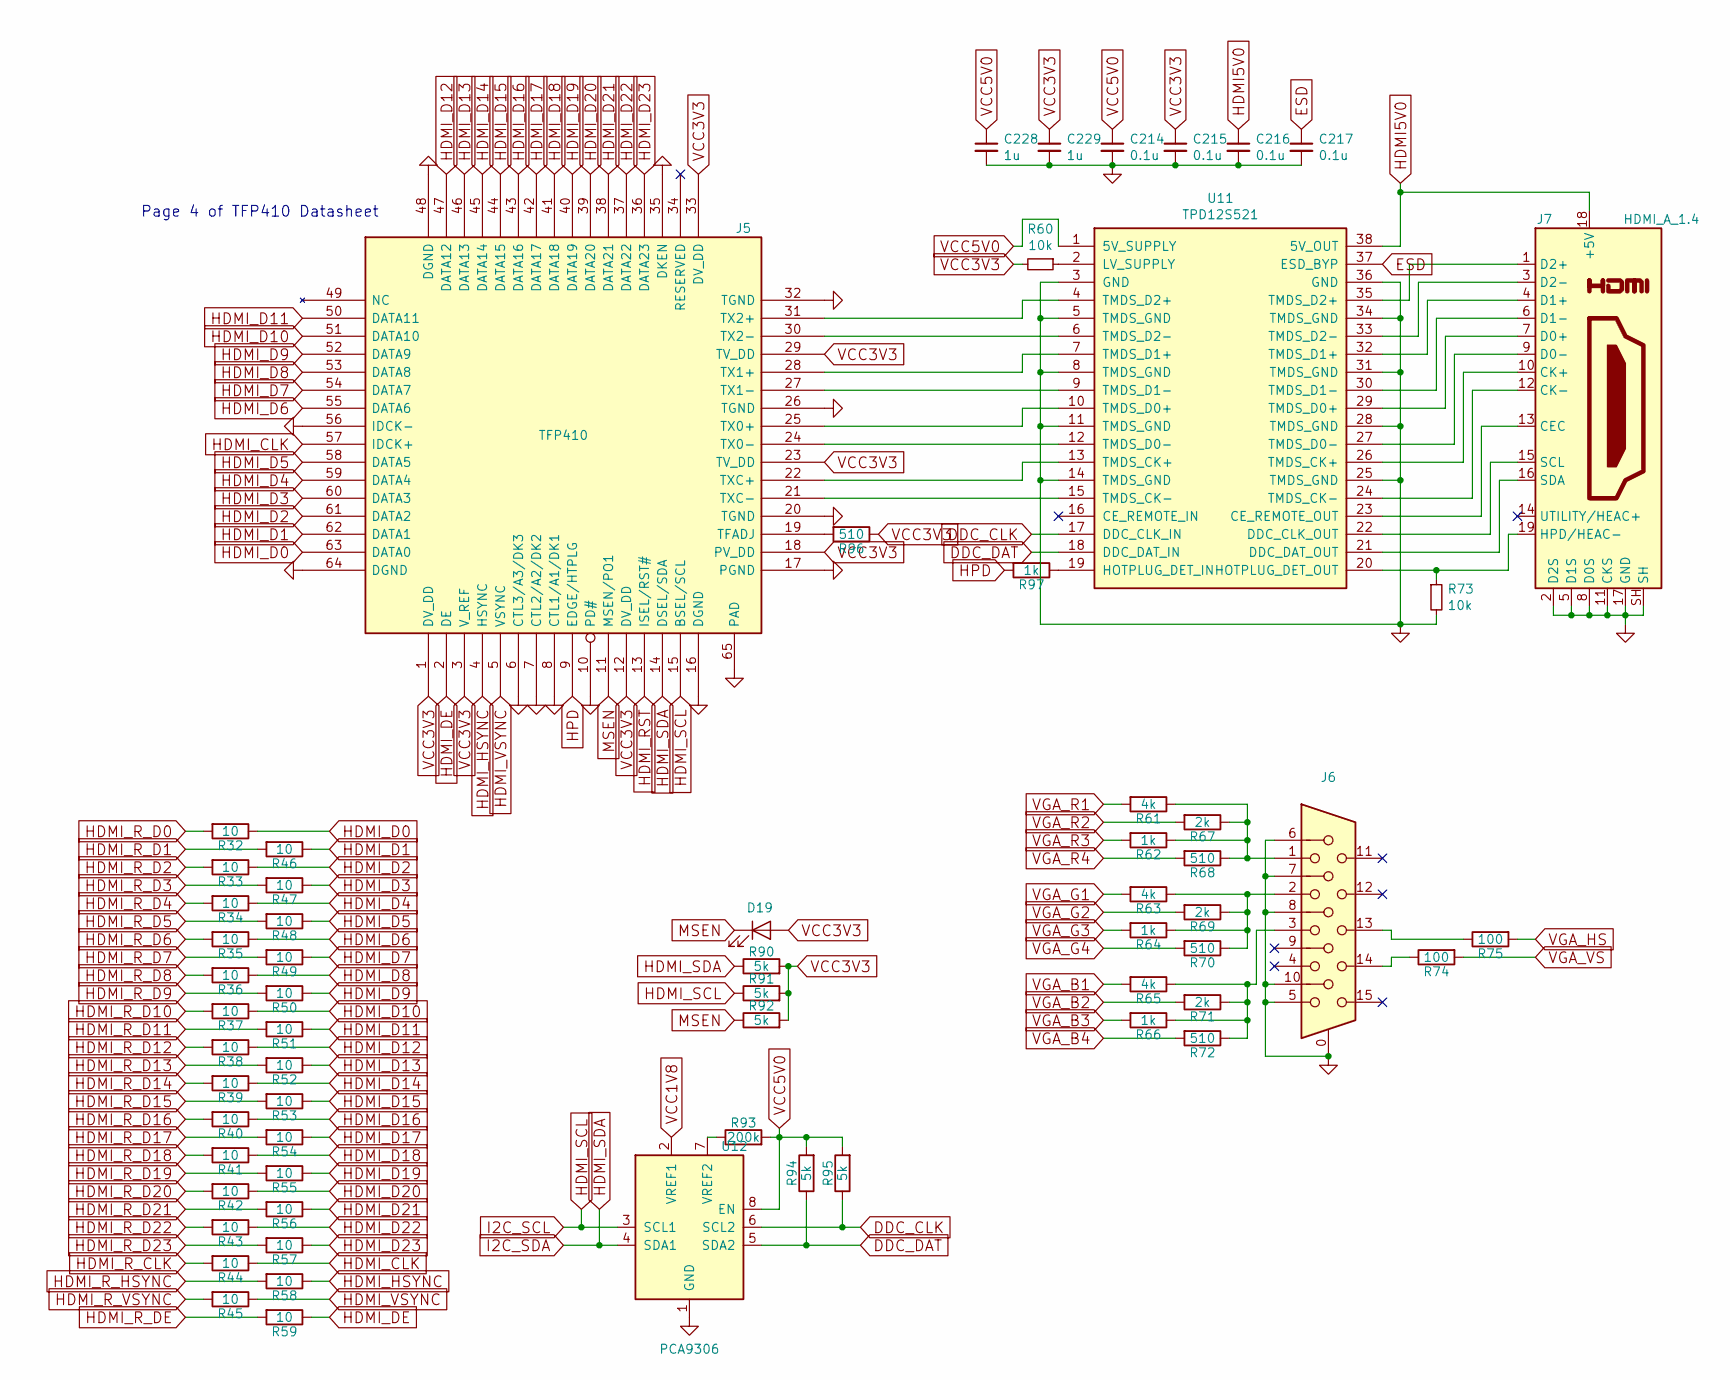
[picture p16: schematic HDMI_VGA.sch, Reconfigurable Application-Specific Accelerator Card]

Parts:
C214, C215, C216, C217: 0.1u; C_0805
C228, C229: 1u; C_0805
D19: LED; LED_0603
J5: TFP410; HTQFP-64-1EP_10x10mm_Pitch0.5mm_ThermalPad
J6: DB15_Female_HighDensity_MountingHoles; DSUB-15-HD_Female_Horizontal_Pitch2.29x1.98mm_EdgePinOffset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
J7: HDMI_A_1.4; HDMI_A
R32, R33, R34, R35, R36, R37, R38, R39, R40, R41, R42, R43, R44, R45, R46, R47, R48, R49, R50, R51, R52, R53, R54, R55, R56, R57, R58, R59: 10; R_0603
R60, R73: 10k; R_0805
R61, R63, R65: 4k; R_0805
R62, R64, R66, R97: 1k; R_0805
R67, R69, R71: 2k; R_0805
R68, R70, R72, R96: 510; R_0805
R74, R75: 100; R_0603
R90, R91, R92, R94, R95: 5k; R_0805
R93: 200k; R_0805
U11: TPD12S521; TSSOP-38_4.4x9.7mm_Pitch0.5mm
U12: PCA9306; VSSOP-8_2.4x2.1mm_Pitch0.5mm

Connections:
DDC_CLK: R95.1, U11.17 (DDC_CLK_IN), U12.6 (SCL2)
DDC_DAT: R94.1, U11.18 (DDC_DAT_IN), U12.5 (SDA2)
ESD: C217.1, U11.37 (ESD_BYP)
GND: C214.2, C215.2, C216.2, C217.2, C228.2, C229.2, J5.6 (CTL3/A3/DK3), J5.7 (CTL2/A2/DK2), J5.8 (CTL1/A1/DK1), J5.10 (PD#), J5.16 (DGND), J5.17 (PGND), J5.20 (TGND), J5.26 (TGND), J5.32 (TGND), J5.35 (DKEN), J5.48 (DGND), J5.56 (IDCK-), J5.64 (DGND), J5.65 (PAD), J6.0, J6.5, J6.6, J6.7, J6.8, J6.10, J7.2 (D2S), J7.5 (D1S), J7.8 (D0S), J7.11 (CKS), J7.17 (GND), J7.SH, R73.2, U11.3 (GND), U11.5 (TMDS_GND), U11.8 (TMDS_GND), U11.11 (TMDS_GND), U11.14 (TMDS_GND), U11.25 (TMDS_GND), U11.28 (TMDS_GND), U11.31 (TMDS_GND), U11.34 (TMDS_GND), U11.36 (GND), U12.1 (GND); also elsewhere on the board
HDMI5V0: C216.1, J7.18 (+5V), U11.38 (5V_OUT)
HDMI_CLK: J5.57 (IDCK+), R44.1
HDMI_D0: J5.63 (DATA0), R32.1
HDMI_D1: J5.62 (DATA1), R46.1
HDMI_D2: J5.61 (DATA2), R33.1
HDMI_D3: J5.60 (DATA3), R47.1
HDMI_D4: J5.59 (DATA4), R34.1
HDMI_D5: J5.58 (DATA5), R48.1
HDMI_D6: J5.55 (DATA6), R35.1
HDMI_D7: J5.54 (DATA7), R49.1
HDMI_D8: J5.53 (DATA8), R36.1
HDMI_D9: J5.52 (DATA9), R50.1
HDMI_D10: J5.51 (DATA10), R37.1
HDMI_D11: J5.50 (DATA11), R51.1
HDMI_D12: J5.47 (DATA12), R38.1
HDMI_D13: J5.46 (DATA13), R52.1
HDMI_D14: J5.45 (DATA14), R39.1
HDMI_D15: J5.44 (DATA15), R53.1
HDMI_D16: J5.43 (DATA16), R40.1
HDMI_D17: J5.42 (DATA17), R54.1
HDMI_D18: J5.41 (DATA18), R41.1
HDMI_D19: J5.40 (DATA19), R55.1
HDMI_D20: J5.39 (DATA20), R42.1
HDMI_D21: J5.38 (DATA21), R56.1
HDMI_D22: J5.37 (DATA22), R43.1
HDMI_D23: J5.36 (DATA23), R57.1
HDMI_DE: J5.2 (DE), R59.1
HDMI_HSYNC: J5.4 (HSYNC), R58.1
HDMI_RST: J5.13 (ISEL/RST#); also elsewhere on the board
HDMI_R_CLK: R44.2; also elsewhere on the board
HDMI_R_D0: R32.2; also elsewhere on the board
HDMI_R_D1: R46.2; also elsewhere on the board
HDMI_R_D2: R33.2; also elsewhere on the board
HDMI_R_D3: R47.2; also elsewhere on the board
HDMI_R_D4: R34.2; also elsewhere on the board
HDMI_R_D5: R48.2; also elsewhere on the board
HDMI_R_D6: R35.2; also elsewhere on the board
HDMI_R_D7: R49.2; also elsewhere on the board
HDMI_R_D8: R36.2; also elsewhere on the board
HDMI_R_D9: R50.2; also elsewhere on the board
HDMI_R_D10: R37.2; also elsewhere on the board
HDMI_R_D11: R51.2; also elsewhere on the board
HDMI_R_D12: R38.2; also elsewhere on the board
HDMI_R_D13: R52.2; also elsewhere on the board
HDMI_R_D14: R39.2; also elsewhere on the board
HDMI_R_D15: R53.2; also elsewhere on the board
HDMI_R_D16: R40.2; also elsewhere on the board
HDMI_R_D17: R54.2; also elsewhere on the board
HDMI_R_D18: R41.2; also elsewhere on the board
HDMI_R_D19: R55.2; also elsewhere on the board
HDMI_R_D20: R42.2; also elsewhere on the board
HDMI_R_D21: R56.2; also elsewhere on the board
HDMI_R_D22: R43.2; also elsewhere on the board
HDMI_R_D23: R57.2; also elsewhere on the board
HDMI_R_DE: R59.2; also elsewhere on the board
HDMI_R_HSYNC: R58.2; also elsewhere on the board
HDMI_R_VSYNC: R45.2; also elsewhere on the board
HDMI_SCL: J5.15 (BSEL/SCL), R91.1, U12.3 (SCL1); also elsewhere on the board
HDMI_SDA: J5.14 (DSEL/SDA), R90.1, U12.4 (SDA1); also elsewhere on the board
HDMI_VSYNC: J5.5 (VSYNC), R45.1
HPD: J5.9 (EDGE/HTPLG), R97.2
MSEN: D19.1 (K), J5.11 (MSEN/PO1), R92.1
unnamed: J5.19 (TFADJ), R96.2
unnamed: J5.21 (TXC-), U11.15 (TMDS_CK-)
unnamed: J5.22 (TXC+), U11.13 (TMDS_CK+)
unnamed: J5.24 (TX0-), U11.12 (TMDS_D0-)
unnamed: J5.25 (TX0+), U11.10 (TMDS_D0+)
unnamed: J5.27 (TX1-), U11.9 (TMDS_D1-)
unnamed: J5.28 (TX1+), U11.7 (TMDS_D1+)
unnamed: J5.30 (TX2-), U11.6 (TMDS_D2-)
unnamed: J5.31 (TX2+), U11.4 (TMDS_D2+)
unnamed: J6.1, R61.1, R62.1, R67.1, R68.1
unnamed: J6.2, R63.1, R64.1, R69.1, R70.1
unnamed: J6.3, R65.1, R66.1, R71.1, R72.1
unnamed: J6.13, R75.1
unnamed: J6.14, R74.1
unnamed: J7.1 (D2+), U11.35 (TMDS_D2+)
unnamed: J7.3 (D2-), U11.33 (TMDS_D2-)
unnamed: J7.4 (D1+), U11.32 (TMDS_D1+)
unnamed: J7.6 (D1-), U11.30 (TMDS_D1-)
unnamed: J7.7 (D0+), U11.29 (TMDS_D0+)
unnamed: J7.9 (D0-), U11.27 (TMDS_D0-)
unnamed: J7.10 (CK+), U11.26 (TMDS_CK+)
unnamed: J7.12 (CK-), U11.24 (TMDS_CK-)
unnamed: J7.13 (CEC), U11.23 (CE_REMOTE_OUT)
unnamed: J7.15 (SCL), U11.22 (DDC_CLK_OUT)
unnamed: J7.16 (SDA), U11.21 (DDC_DAT_OUT)
unnamed: J7.19 (HPD/HEAC-), R73.1, U11.20 (HOTPLUG_DET_OUT)
unnamed: R60.1, U11.2 (LV_SUPPLY)
unnamed: R93.1, U12.7 (VREF2)
unnamed: R97.1, U11.19 (HOTPLUG_DET_IN)
VCC1V8: U12.2 (VREF1); also elsewhere on the board
VCC3V3: C215.1, C229.1, D19.2 (A), J5.1 (DV_DD), J5.3 (V_REF), J5.12 (DV_DD), J5.18 (PV_DD), J5.23 (TV_DD), J5.29 (TV_DD), J5.33 (DV_DD), R60.2, R90.2, R91.2, R92.2, R96.1; also elsewhere on the board
VCC5V0: C214.1, C228.1, R93.2, R94.2, R95.2, U11.1 (5V_SUPPLY), U12.8 (EN); also elsewhere on the board
VGA_B1: R65.2; also elsewhere on the board
VGA_B2: R71.2; also elsewhere on the board
VGA_B3: R66.2; also elsewhere on the board
VGA_B4: R72.2; also elsewhere on the board
VGA_G1: R63.2; also elsewhere on the board
VGA_G2: R69.2; also elsewhere on the board
VGA_G3: R64.2; also elsewhere on the board
VGA_G4: R70.2; also elsewhere on the board
VGA_HS: R75.2; also elsewhere on the board
VGA_R1: R61.2; also elsewhere on the board
VGA_R2: R67.2; also elsewhere on the board
VGA_R3: R62.2; also elsewhere on the board
VGA_R4: R68.2; also elsewhere on the board
VGA_VS: R74.2; also elsewhere on the board

Notes on the sheet:
Page 4 of TFP410 Datasheet

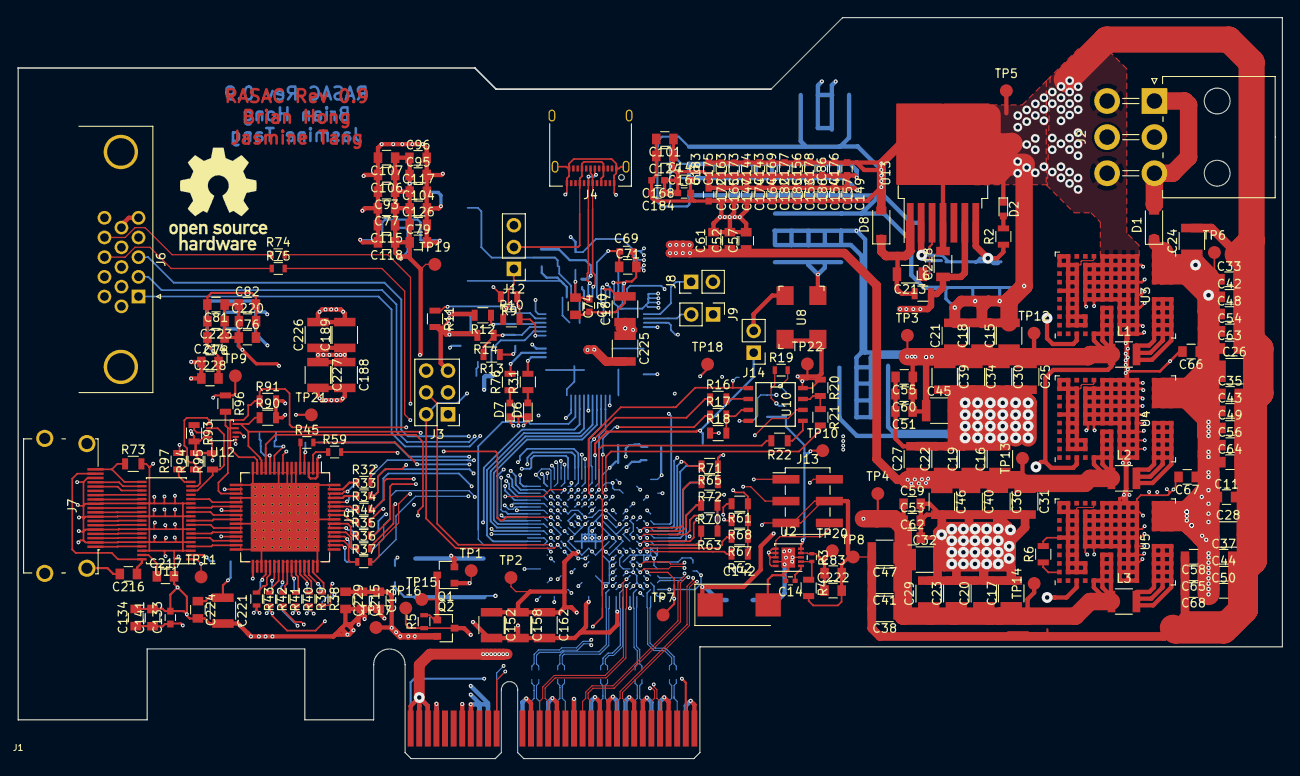
[picture p17: board RASAC.kicad_pcb from above]

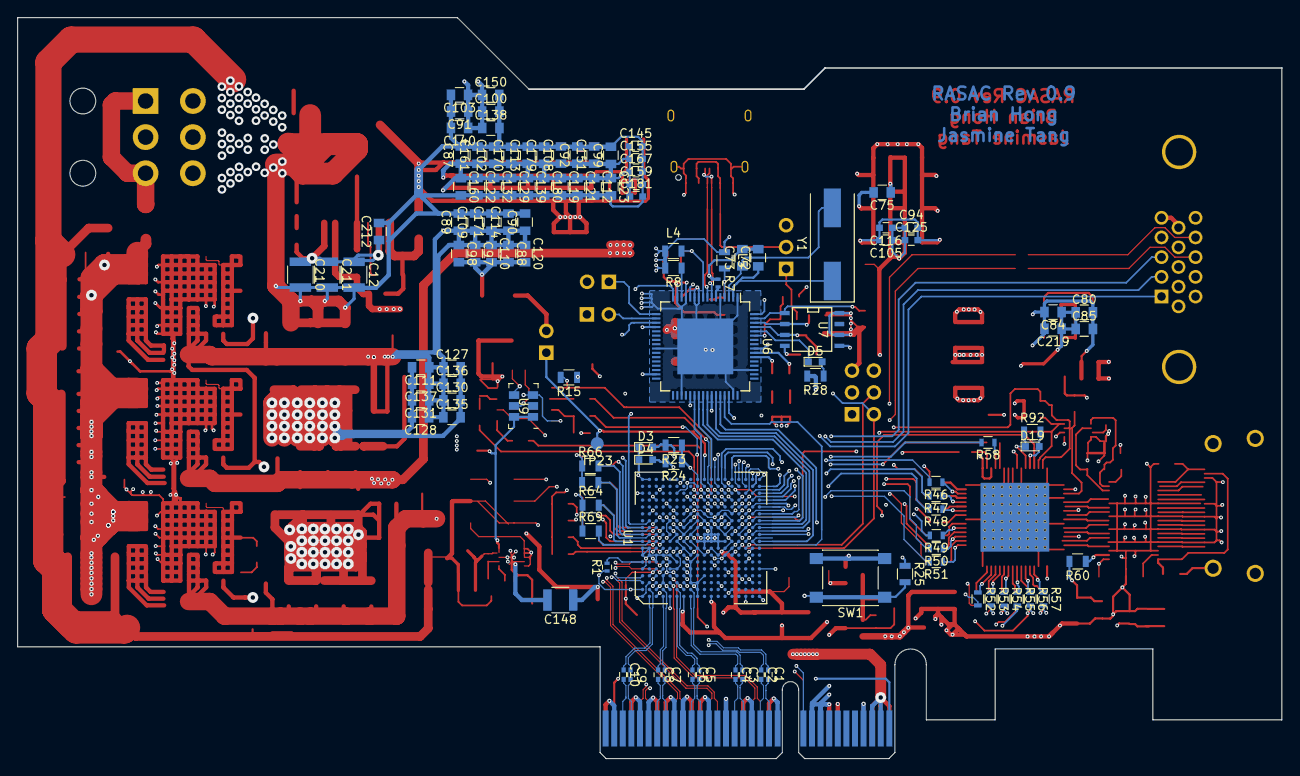
[picture p18: board RASAC.kicad_pcb from below]

Board: 6 copper layers, 147.0 x 86.2 mm, 356 parts (115 on the bottom side), 218 nets.
