RASAC-Dev/RASAC_board/(commit log)

2018-12-17 Added KiCad files
    Schematics done:
    FPGA
    Voltage Regulators
    Configuration
    Debug (JTAG + UART)
    PCIe Interface
    TODO:
    Decoupling Caps
    RAM
    Peripherals (HDMI, etc) + Connectors
    [Bank_0.sch, Config.sch, Connections.sch, Connectors.sch, DDR4.sch, DDR4_1.sch, DDR4_2.sch, DDR4_3.sch]
2018-12-17 Cleanup
    Removed old schematic files
    [Bank_0.sch, Connectors.sch, DDR4.sch]
2018-12-17 Upgraded FPGA
    Changed FPGA part from XC7A25T to XC7A35T
    [Config.sch, Connections.sch, DDR4_1.sch, DDR4_2.sch, DDR4_3.sch, DDR4_4.sch, DDR4_things.sch, Debug.sch]
2018-12-17 Added SYSCLK
    Changed EMCCLK from SiT8103 to SiT8209 because Digikey didn't have.
    Added SiT9102 200MHz for SYSCLK
    [Config.sch, Connections.sch]
2018-12-18 Added HDMI transmitter chip
    Also added resistors and moved HDMI data pins around on FPGA side
    [Config.sch, Connections.sch, HDMI.sch, Power.sch]
2018-12-18 Separated out Docs and FPGA_modules
    [Config.sch, Connections.sch, DDR4_1.sch, DDR4_2.sch, DDR4_3.sch, DDR4_4.sch, DDR4_things.sch, Debug.sch]
2018-12-18 Added VGA
    [Connections.sch, HDMI_VGA.sch, RASAC.sch]
2018-12-18 DDR RAM 32 bits instead of 64bits
    Don't have enough pins :(
    [Config.sch, Connections.sch, DDR4_1.sch, DDR4_2.sch, DDR4_3.sch, DDR4_4.sch, DDR4_things.sch, Debug.sch]
2018-12-18 Cleanup for demo/presentation
    Merged Config and Debug sheets.
    Added GPIO for remaining pins.
    Annotations.
    [Config.sch, Config_Debug.sch, Connections.sch, DDR4_1.sch, DDR4_2.sch, Debug.sch, GPIO_USB.sch, HDMI_VGA.sch]
2019-01-29 Added Decoupling Caps?
    [Config_Debug.sch, Connections.sch, DDR4_1.sch, DDR4_2.sch, Decoupling.sch, GPIO_USB.sch, HDMI_VGA.sch, PCIe_interface.sch]
2019-01-30 Cleanup + Update to KiCad 5.0 + DDR2
    Updated to KiCad 5, which re-organized libraries, so corrected them to not need RASAC-rescue.lib.
    Also cleaned up some stuff.
    DDR4 has been removed and in place will be DDR2.
    [Config_Debug.sch, Connections.sch, DDR2_1.sch, DDR2_2.sch, Decoupling.sch, GPIO_USB.sch, HDMI_VGA.sch, PCIe_interface.sch]
2019-01-30 Minor fixes
    Still fixing from KiCad update
    [Config_Debug.sch, Decoupling.sch, HDMI_VGA.sch, PCIe_interface.sch]
2019-02-02 More fixes
    [Config_Debug.sch, Power.sch]
2019-02-02 Added TPD12S521 Port Protection for HDMI
    [HDMI_VGA.sch]
2019-02-03 Finished HDMI. Added I2C
    [Config_Debug.sch, Connections.sch, DDR2_1.sch, DDR2_2.sch, Decoupling.sch, GPIO_USB.sch, HDMI_VGA.sch]
2019-02-24 Config_Debug and PCIe sheets look done
    Added jumpers to JTAG chain.
    Placed NCs on not used pins.
    PCIe_PRSNT_B should be connected to the furthest PCIe_PRSNT_#.
    [Config_Debug.sch, PCIe_interface.sch]
2019-02-24 HDMI_VGA is good. Need 5V for HDMI
    TODO: DDR2, connections, power
    [Config_Debug.sch, Connections.sch, DDR2_1.sch, DDR2_2.sch, Decoupling.sch, HDMI_VGA.sch, PCIe_interface.sch, Power.sch]
2019-02-26 Cleanup for DRC and HDMI. HDMI and DDR2 looks good
    DRC returns 5 errors with POWEROUTPUT-POWEROUTPUT set as good.
    3 of them come from 3V3 since it's being driven from a MOSFET.
    1 of them from VCC5V0 not yet supplied.
    1 of them from USB_VBUS not set as output.
    5V supply for HDMI
    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
    [Config_Debug.sch, Connections.sch, DDR2_1.sch, DDR2_2.sch, HDMI_VGA.sch, PCIe_interface.sch, Power.sch]
2019-02-26 Added 5V supply for HDMI.
    Added jumper for USB-C power
    Add more jumpers (EMCCLK and Config)
    Add lots of test points
    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
    [Config_Debug.sch, Power.sch]
2019-02-27 Added more caps and jumpers for EMCCLK & Config
    [Config_Debug.sch, Connections.sch]
2019-02-27 More caps and added lots of test points
    [Config_Debug.sch, DDR2_1.sch, DDR2_2.sch, HDMI_VGA.sch, Power.sch]
2019-02-27 Annotations and proper connections
    [Config_Debug.sch, Connections.sch, DDR2_1.sch, DDR2_2.sch, HDMI_VGA.sch, Power.sch]
2019-02-27 Attempted to add USB-C and then reverted
    File still saved locally
    [Config_Debug.sch, Connections.sch, DDR2_1.sch, DDR2_2.sch, Decoupling.sch, HDMI_VGA.sch, PCIe_interface.sch, Power.sch]
2019-02-27 Started mapping footprints
    [PCIe_interface.sch, Power.sch]
2019-02-27 Finished capacitor footprints
    Total cost: ~$55
    [Config_Debug.sch, Connections.sch, DDR2_1.sch, DDR2_2.sch, Decoupling.sch, HDMI_VGA.sch, Power.sch]
2019-02-27 Almost done with footprints. See issues below
    Inductors left to do.
    Others without footprints need custom.
    PI3420 is out of stock...
    LM2676 symbol should be re-drawn for TO-263-7
    Total cost: ~$214
    [Config_Debug.sch, DDR2_1.sch, DDR2_2.sch, HDMI_VGA.sch, PCIe_interface.sch, Power.sch]
2019-02-27 Replaced PCIe x4 footprint
    Footprint generated with https://github.com/dlharmon/footgen
    [PCIe_interface.sch]
2019-02-27 Fixed LM2676
    [Power.sch]
2019-02-27 Should've been part of previous commit
    [Power.sch]
2019-02-27 LGA-123 Drawn and added
    PI3420 will come from Mouser...
    [Power.sch]
2019-02-28 Drew some more footprints
    BTW another DRC error popped up since I2C level shifter now uses VCC5V0
    FPGA footprint + Inductors and FETs
    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
    [Config_Debug.sch, Power.sch]
2019-02-28 Inductors and FETs footprints
    FPGA and HDMI foorprints
    Layout
    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
    [Config_Debug.sch, Power.sch]
2019-02-28 Drew FPGA and HDMI footprints
    Ready for layout...?
    [Config_Debug.sch, Connections.sch, HDMI_VGA.sch, PCIe_interface.sch, Power.sch]
2019-02-28 Schematics reformatted for A size
    I think rev 1.0 is ready
    [Config_Debug.sch, Connections.sch, DDR2_1.sch, DDR2_2.sch, Decoupling.sch, HDMI_VGA.sch, PCIe_interface.sch, Power.sch]
2019-03-06 Fixes during layout
    Changed FT2232HL footprint to one with external pad
    Made LGA123 (PI34XX) pins into blocks
    Added labels for PCIe to let KiCad do differential pair routing
    Removed some ground connections in SGND in PI34XX
    [Config_Debug.sch, PCIe_interface.sch, Power.sch]
2019-03-06 Initial layout (in progress)
    Power input finished (?)
    First attempt at PCIe connections; will probably have to re-do
    Started on RAM
    [RASAC.kicad_pcb]
2019-03-19 PCB Layout
    Don't remember what changed, but gonna push before my computer dies again
    [RASAC.kicad_pcb]
2019-03-19 Initial FPGA routing + 3D RAM
    Slowly losing insanity while listening to WII music for hours
    [DDR2_1.sch, DDR2_2.sch, RASAC.kicad_pcb]
2019-03-20 PCIe + RAM Layout?
    Is this PCIe even going to work...?
    [RASAC.kicad_pcb]
2019-03-24 RAM+FPGA Attempt #1
    Oh geez
    [RASAC.kicad_pcb]
2019-03-26 RAM+FPGA Attempt #2
    Plus some power connections
    [RASAC.kicad_pcb]
2019-03-26 OH MY GOD
    [RASAC.kicad_pcb]
2019-03-31 More RAM routing
    [RASAC.kicad_pcb]
2019-04-01 Purged RAM (SCH)
    Was taking way too lon of a time which I didn't have
    Also using larger resistors and capacitors than 0402 and 0201 (expect a very few)
    [Config_Debug.sch, Connections.sch, Decoupling.sch, HDMI_VGA.sch, PCIe_interface.sch, Power.sch, RASAC.sch]
2019-04-01 Minor wiring fix
    [HDMI_VGA.sch]
2019-04-01 Purged RAM (PCB) and updated RC footprints
    [RASAC.kicad_pcb]
2019-04-01 UART + JTAG + half of HDMI
    Also resized HDMI resistors from 1206 to 0603
    [HDMI_VGA.sch, RASAC.kicad_pcb]
2019-04-02 More HDMI
    [RASAC.kicad_pcb]
2019-04-02 Some more HDMI + power
    [RASAC.kicad_pcb]
2019-04-02 HDMI Done?
    [RASAC.kicad_pcb]
2019-04-02 Almost done
    Just gotta do capacitors, I think
    [RASAC.kicad_pcb]
2019-04-03 Am... Am I done...?
    [RASAC.kicad_pcb]
2019-04-03 Added text + logo + output files
    [RASAC-B.Cu.gbr, RASAC-B.Mask.gbr, RASAC-B.Paste.gbr, RASAC-B.SilkS.gbr, RASAC-Edge.Cuts.gbr, RASAC-F.Cu.gbr, RASAC-F.Mask.gbr, RASAC-F.Paste.gbr]
